thomasplantin/FireWorks2020/images/Schematic.pdf

# GND GNDprobe2

# GNDprobe3

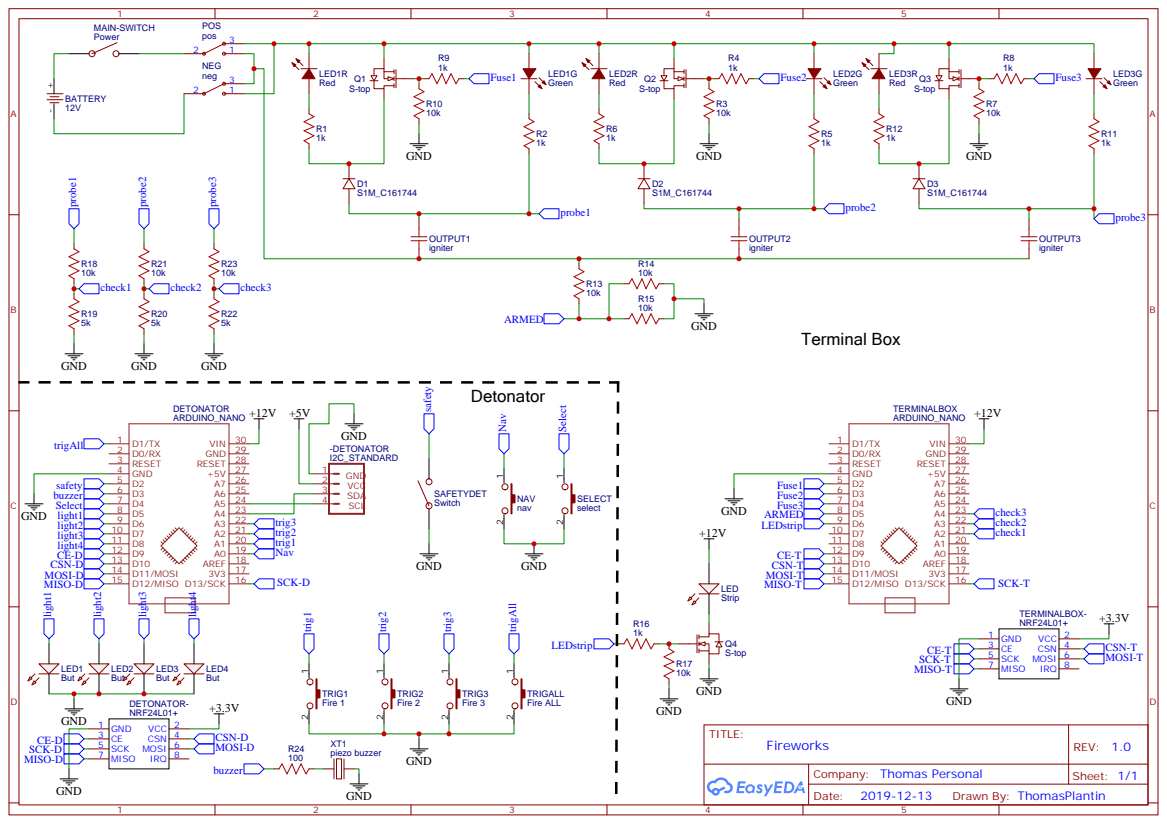
[picture p2: page 1]
